xonik/eII-psu-psb/eii-psu-thr-hole-psb-v1.1.brd

## EAGLE design eii-psu-thr-hole-psb-v1.1.brd (2022-04-08)

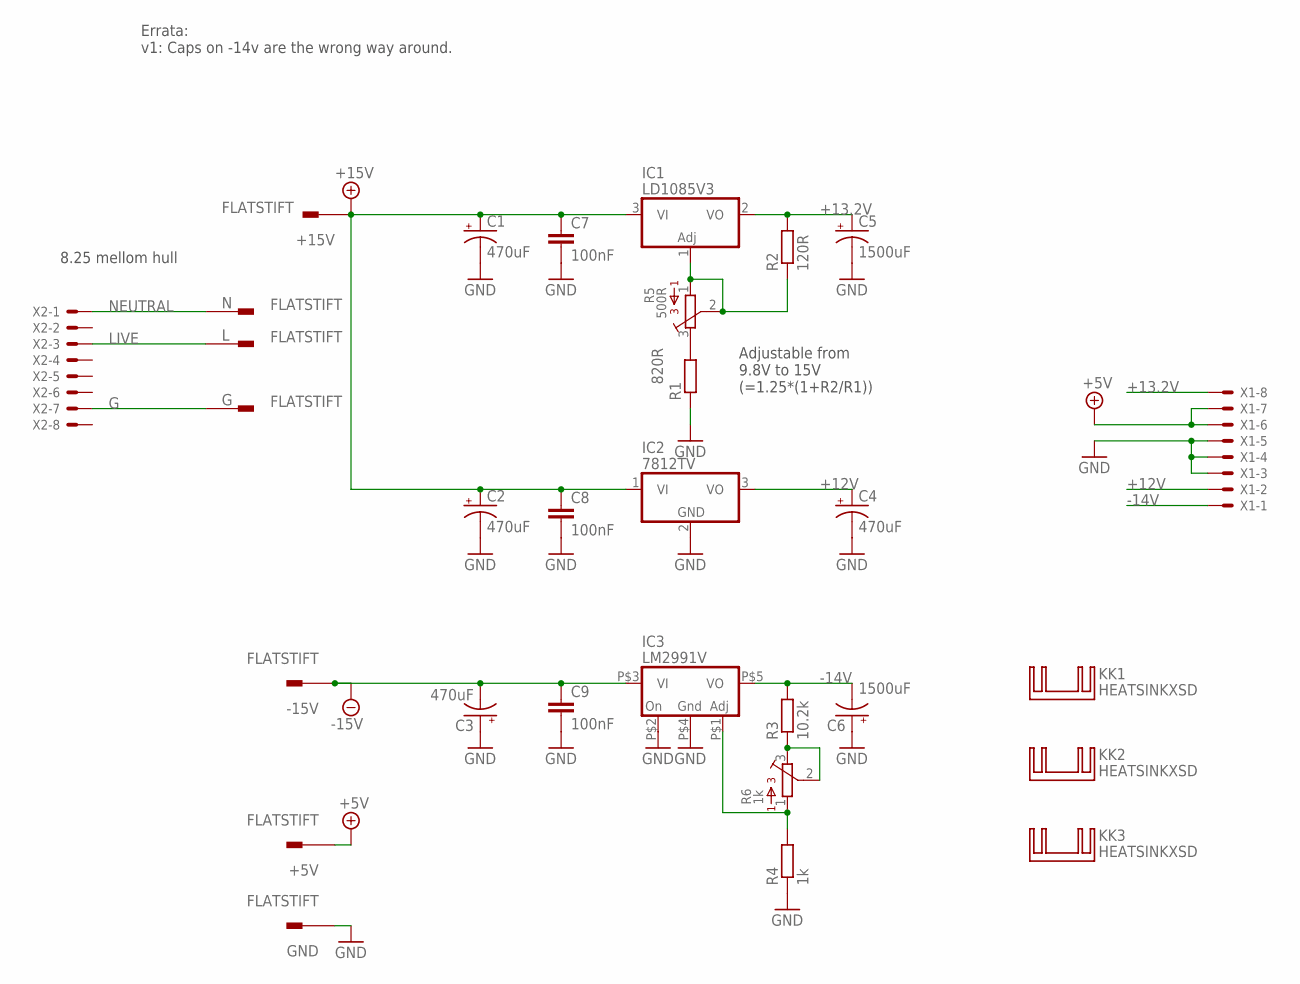
[picture p1: schematic eii-psu-thr-hole-psb-v1.1.sch]

Parts:
+5V, +15V: FLATSTIFT
-15V: FLATSTIFT
C1, C2, C3, C4: 470uF; E5-10,5
C5, C6: 1500uF; E5-13
C7, C8, C9: 100nF; C050-030X075
G: FLATSTIFT
GND: FLATSTIFT
IC1: LD1085V3; TO220V-J
IC2: 7812TV; TO220V
IC3: LM2991V; TO220-5V-J
KK1, KK2, KK3: HEATSINKXSD; XSD1226-005
L: FLATSTIFT
N: FLATSTIFT
R1: 820R; 0207/7
R2: 120R; 0207/7
R3: 10.2k; 0207/7
R4: 1k; 0207/7
R5: 500R; 3362P
R6: 1k; 3362P
X1, X2: KK-156-8

Connections:
+5V: +5V.F, +5V.F2, X1.6, X1.7
+12V: C4.+, IC2.3 (VO), X1.2
+13.2V: C5.+, IC1.2 (VO), R2.2, X1.8
+15V: +15V.F, +15V.F2, C1.+, C2.+, C7.1, C8.1, IC1.3 (VI), IC2.1 (VI)
-14V: C6.-, IC3.P$5 (VO), R3.2, X1.1
-15V: -15V.F, -15V.F2, C3.-, C9.1, IC3.P$3 (VI)
G: G.F, G.F2, X2.7
GND: C1.-, C2.-, C3.+, C4.-, C5.-, C6.+, C7.2, C8.2, C9.2, GND.F, GND.F2, IC2.2 (GND), IC3.P$2 (ON), IC3.P$4 (GND), R1.1, R4.1, X1.3, X1.4, X1.5
LIVE: L.F, L.F2, X2.3
unnamed: R1.2, R5.3
unnamed: IC1.1 (ADJ), R2.1, R5.1, R5.2
unnamed: R3.1, R6.2, R6.3
unnamed: IC3.P$1 (ADJ), R4.2, R6.1
NEUTRAL: N.F, N.F2, X2.1

Notes on the sheet:
Adjustable from 9.8V to 15V (=1.25*(1+R2/R1))
8.25 mellom hull
Errata: v1: Caps on -14v are the wrong way around.

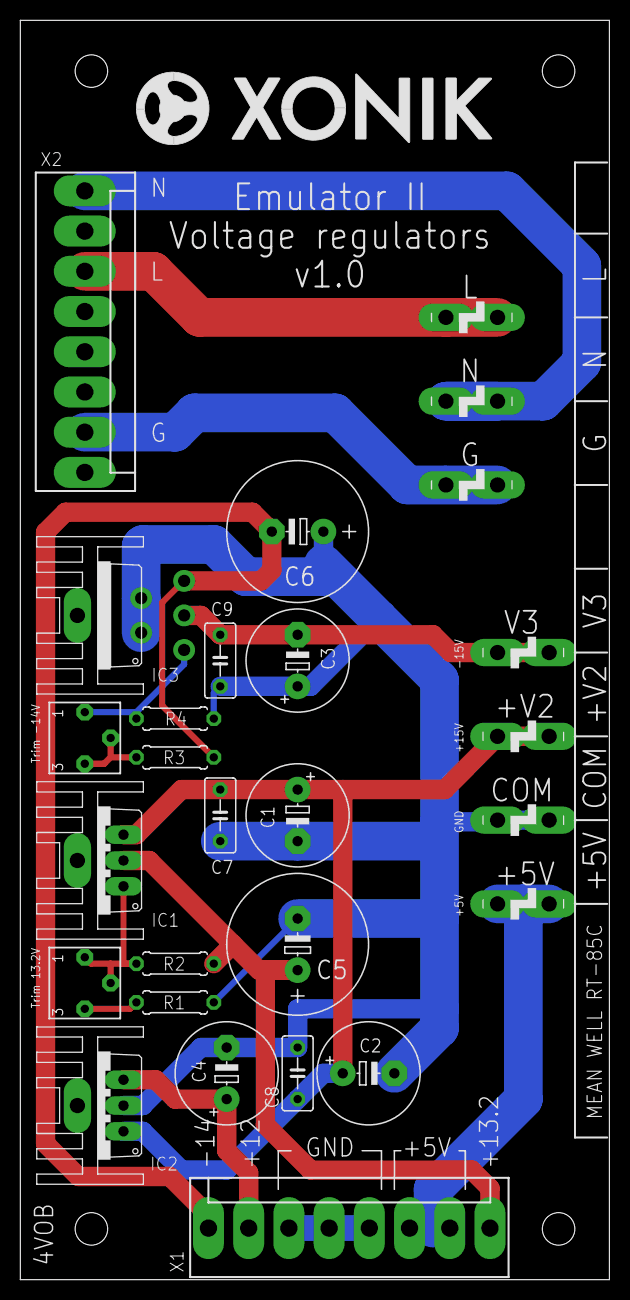
[picture p2: board eii-psu-thr-hole-psb-v1.1.brd from above]

Board: 2 copper layers, 58.0 x 124.0 mm, 31 parts (0 on the bottom side), 14 nets.

Other parts of the board:
U$3: XONIK_LOGO_35
