xonik/eII-psu-psb/eii-psu-psb.brd

## EAGLE design eii-psu-psb.brd (2021-08-31)

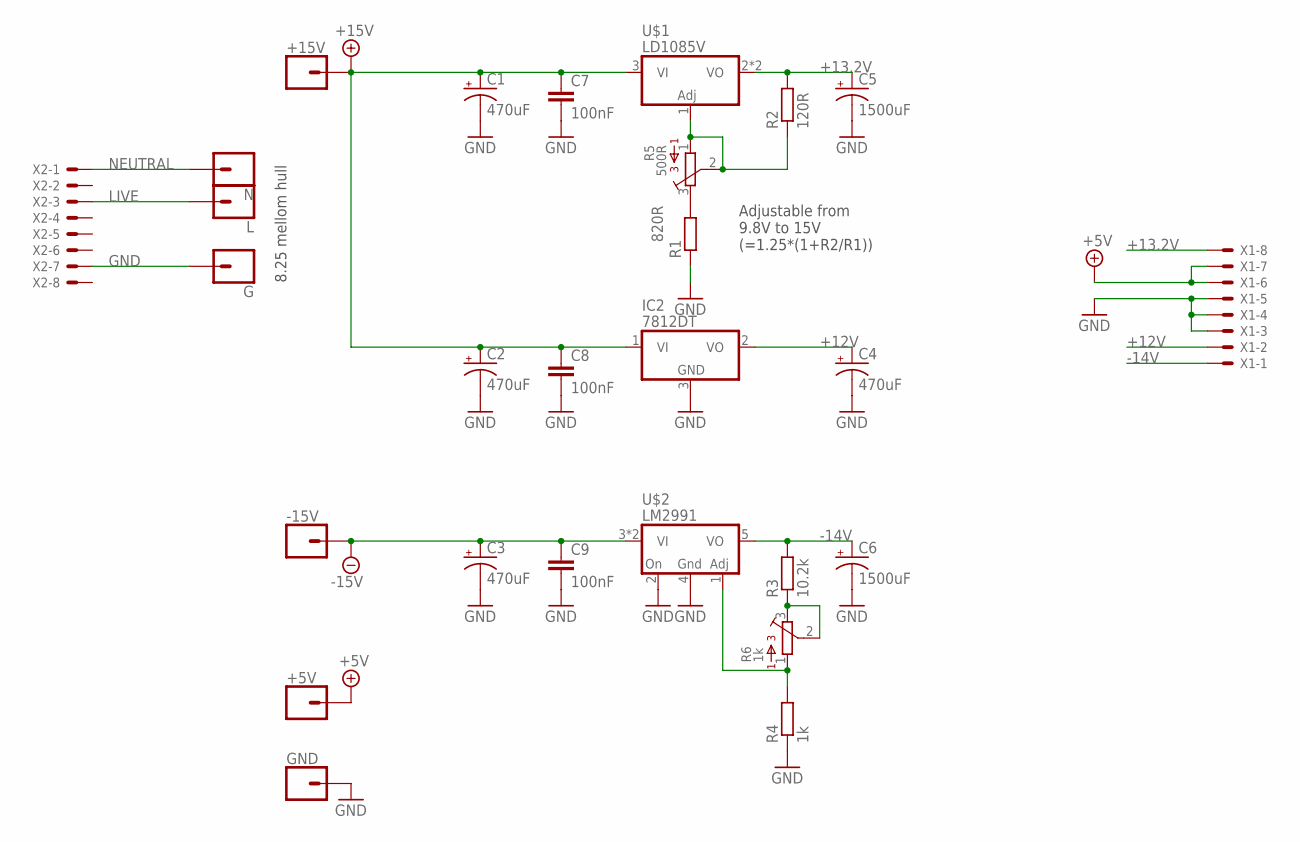
[picture p3: schematic eii-psu-psb.sch]

Parts:
+5V, +15V: CONN_01PTH_2MM; 1X01_2MM
-15V: CONN_01PTH_2MM; 1X01_2MM
C1, C2, C3, C4: 470uF; E5-10,5
C5, C6: 1500uF; E5-13
C7, C8, C9: 100nF; C050-030X075
G: CONN_01PTH_2MM; 1X01_2MM
GND: CONN_01PTH_2MM; 1X01_2MM
IC2: 7812DT; TO252
L: CONN_01PTH_2MM; 1X01_2MM
N: CONN_01PTH_2MM; 1X01_2MM
R1: 820R; R1206
R2: 120R; R1206
R3: 10.2k; R1206
R4: 1k; R1206
R5: 500R; 3362P
R6: 1k; 3362P
U$1: LD1085V; TO263-3J
U$2: LM2991; TO263-5J
X1, X2: KK-156-8

Connections:
+5V: +5V.1, X1.6, X1.7
+12V: C4.+, IC2.2 (VO), X1.2
+13.2V: C5.+, R2.2, U$1.2 (VO), U$1.TAB (VO), X1.8
+15V: +15V.1, C1.+, C2.+, C7.1, C8.1, IC2.1 (VI), U$1.3 (VI)
-14V: C6.+, R3.2, U$2.5 (VO), X1.1
-15V: -15V.1, C3.+, C9.1, U$2.3 (VI), U$2.6 (VI)
GND: C1.-, C2.-, C3.-, C4.-, C5.-, C6.-, C7.2, C8.2, C9.2, G.1, GND.1, IC2.3 (GND), R1.1, R4.1, U$2.2 (ON), U$2.4 (GND), X1.3, X1.4, X1.5, X2.7
LIVE: L.1, X2.3
unnamed: R1.2, R5.3
unnamed: R2.1, R5.1, R5.2, U$1.1 (ADJ)
unnamed: R3.1, R6.2, R6.3
unnamed: R4.2, R6.1, U$2.1 (ADJ)
NEUTRAL: N.1, X2.1

Notes on the sheet:
Adjustable from 9.8V to 15V (=1.25*(1+R2/R1))
8.25 mellom hull

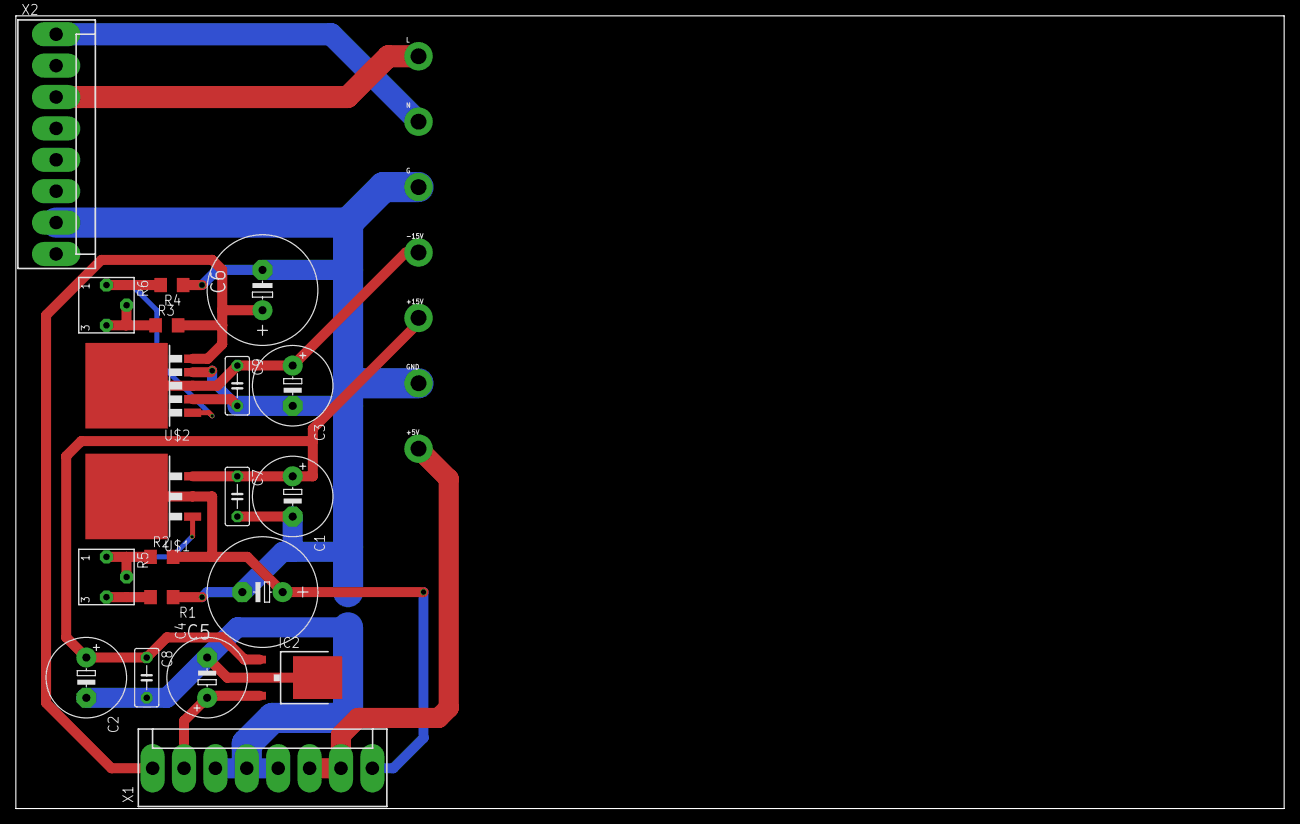
[picture p4: board eii-psu-psb.brd from above]

Board: 2 copper layers, 160.0 x 100.0 mm, 27 parts (0 on the bottom side), 13 nets.
