xonik/eII-psu-psb/(commit log)

2021-08-31 First version, need to place things properly
    [eii-psu-psb.brd, eii-psu-psb.sch]
2021-12-21 Through hole version
    [eii-psu-thr-hole-psb.brd, eii-psu-thr-hole-psb.sch]
2021-12-22 Switched to through-hole resistors too
    [eii-psu-thr-hole-psb.brd, eii-psu-thr-hole-psb.sch]
2021-12-22 Removed crossing neutral/live
    [eii-psu-thr-hole-psb.brd]
2021-12-25 New heat sinks, better silk screen
    [eii-psu-thr-hole-psb.brd, eii-psu-thr-hole-psb.sch]
2021-12-25 Tweaks after uploading to JLCPCB
    [eii-psu-thr-hole-psb.brd]
2021-12-28 Added all parts except regulators
    [eii-psu-thr-hole-psb.brd, eii-psu-thr-hole-psb.sch, eii-psu-thr-hole-psb_top_bom.csv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]
2022-01-07 Added tray to be laser cut
2022-04-08 moving to new pc
    [eii-psu-thr-hole-psb-v1.1.brd, eii-psu-thr-hole-psb-v1.1.sch]
